mlab-modules/DATALOGGER02A/README.md

# DATALOGGER02A
<!--- LongName --->
## 
<!--- ELongName ---> 

<!--- Lead --->

<!--- ELead ---> 

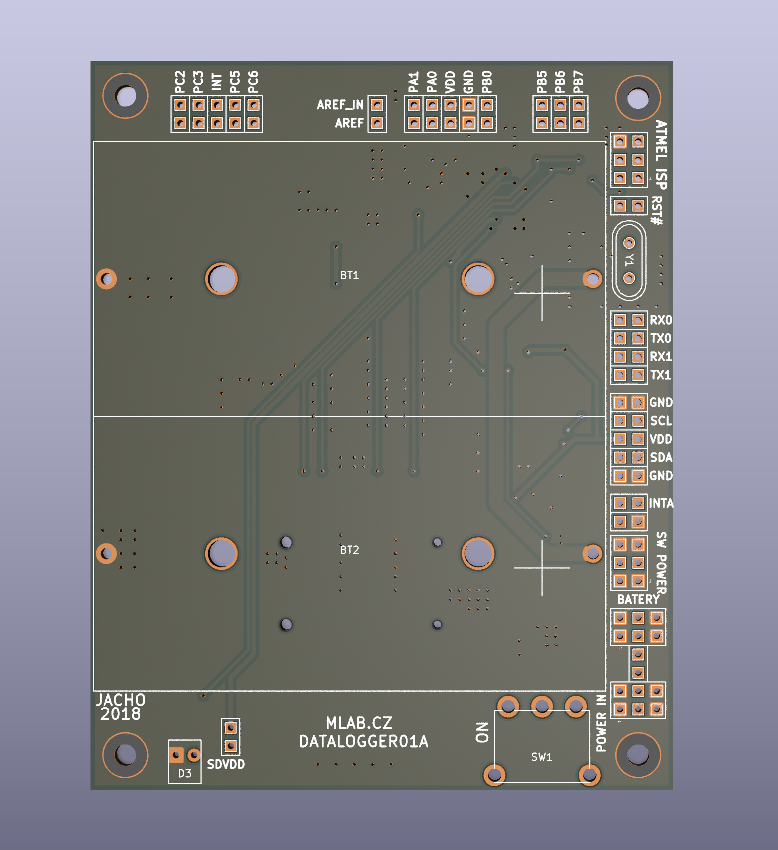
[picture p1: doc/img/DATALOGGER01A_top.png]
DATALOGGER01A
