mlab-modules/DATALOGGER02A/doc/gen/img/DATALOGGER02-bottom.png

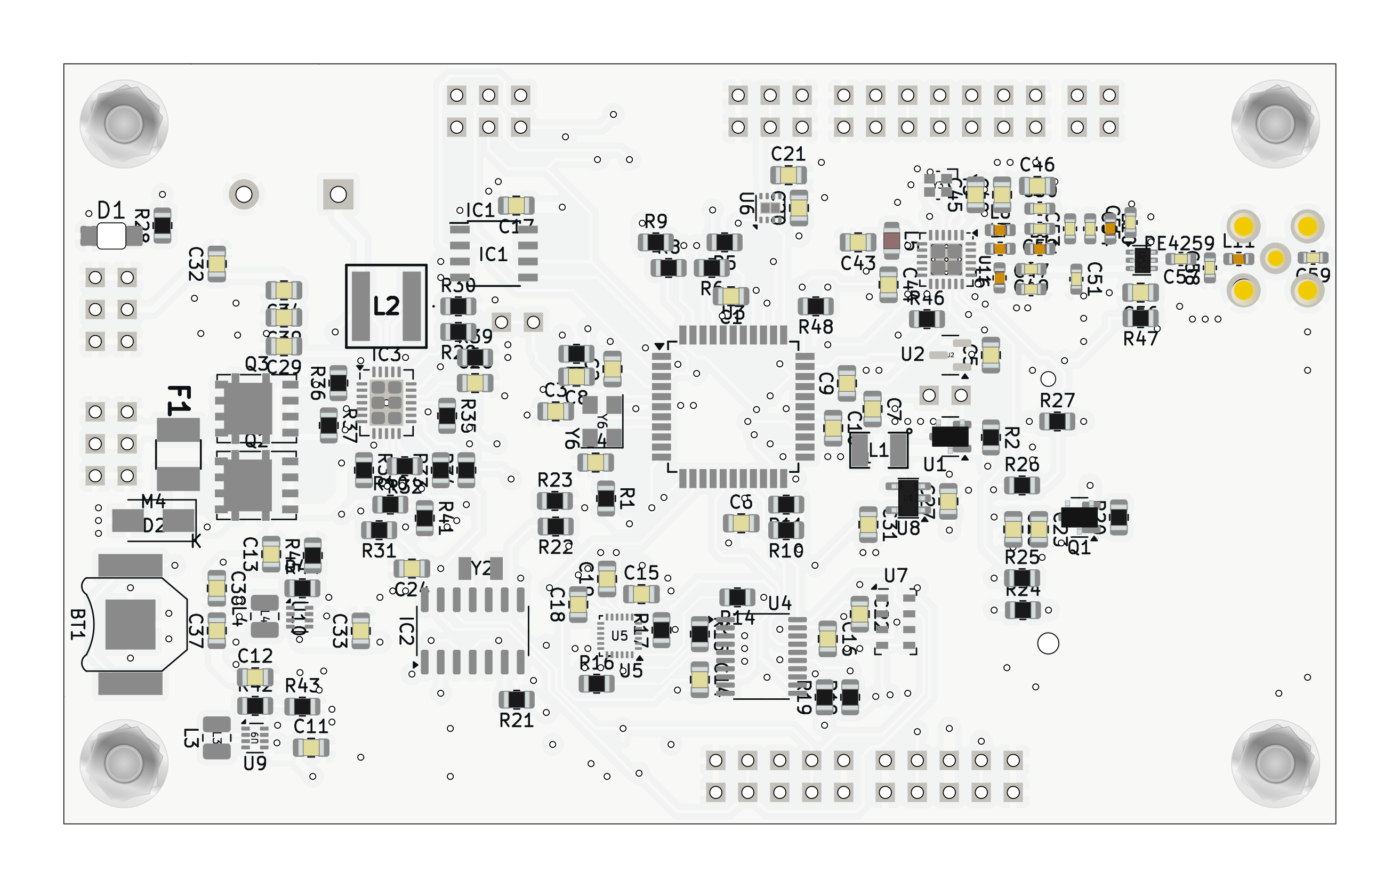
doc/gen/img/DATALOGGER02-bottom.png
