mlab-modules/DATALOGGER02A/doc/gen/img/DATALOGGER02-top.png

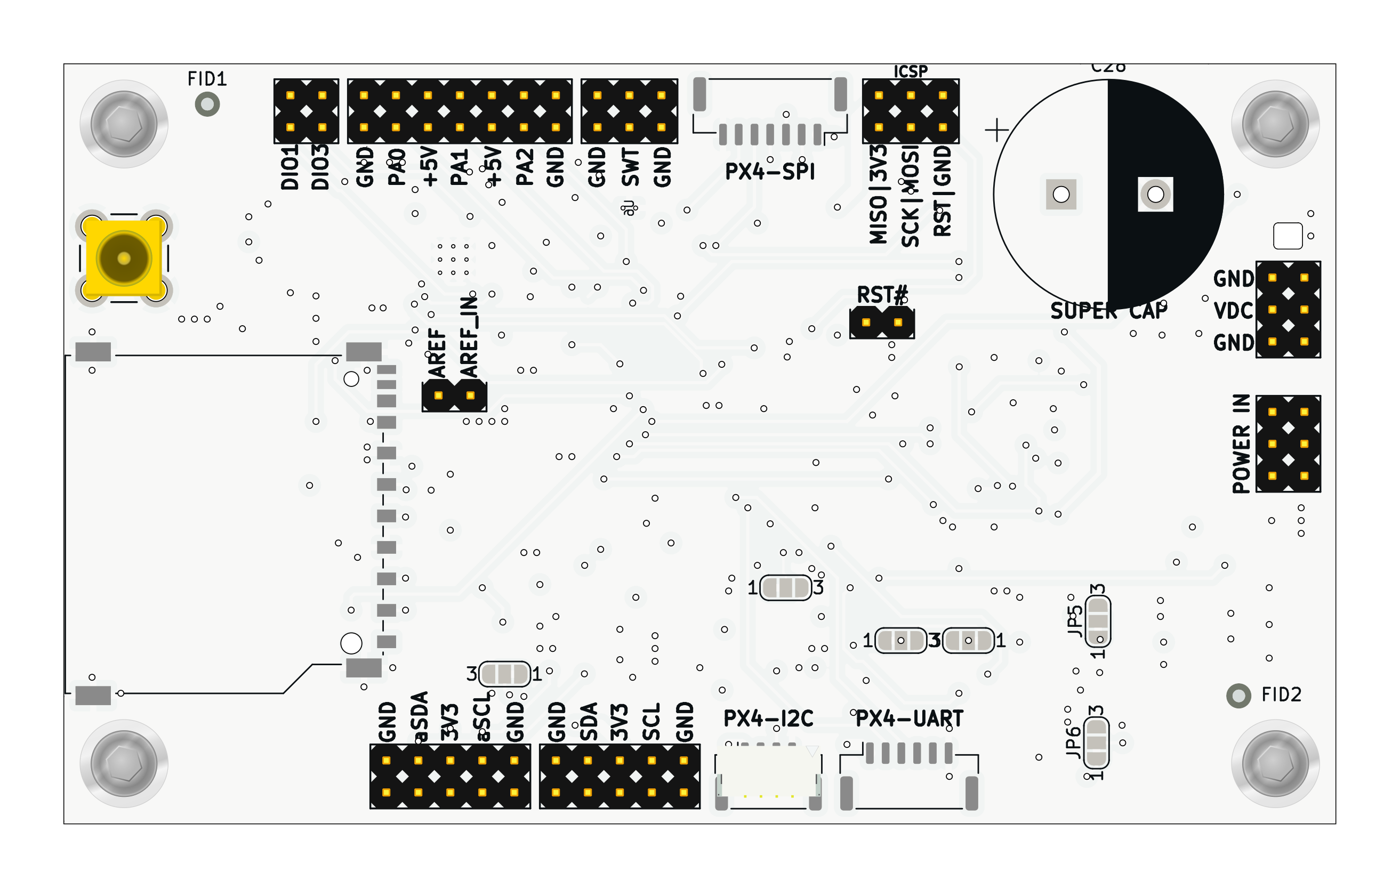
doc/gen/img/DATALOGGER02-top.png
