mlab-modules/DATALOGGER02A/doc/gen/DATALOGGER02.step

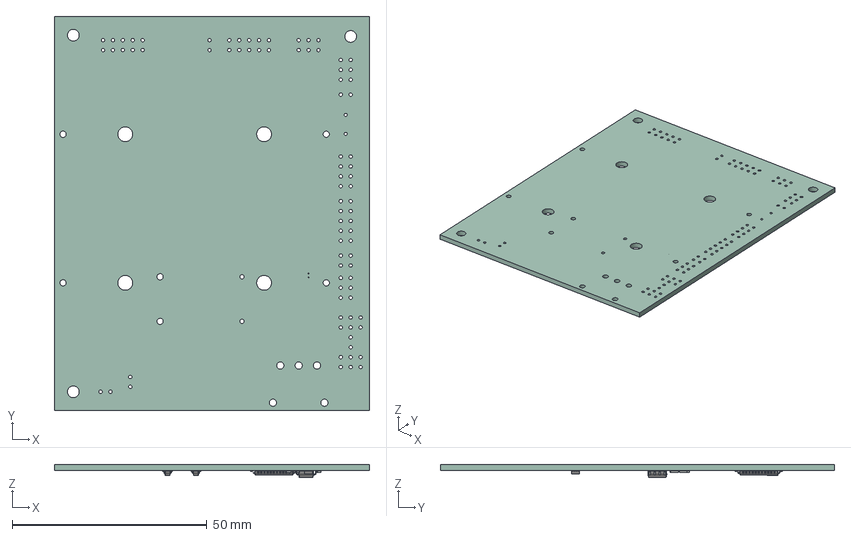
[picture p4: CAD file, 2025-01-04]
doc/gen/DATALOGGER02.step
80.8 x 101.1 x 3.40 mm
WSON_8_1EP_2x2mm_P05mm_EP09x16mm
TQFP_44_10x10mm_P08mm
SOT_23 x 2
R_0805_2012Metric x 5
SOIC_8_39x49mm_P127mm
kibot_lc1u32bj_PCB
