mlab-modules/DATALOGGER02A/doc/gen/dxf/DATALOGGER02-Edge_Cuts.dxf

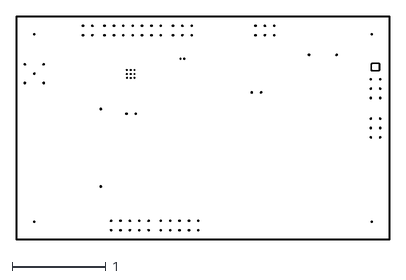
[picture p5: CAD file, 2025-01-23]
doc/gen/dxf/DATALOGGER02-Edge_Cuts.dxf
3.98 x 2.38
