mlab-modules/DATALOGGER02A/doc/gen/dxf/DATALOGGER02-User_Drawings.dxf

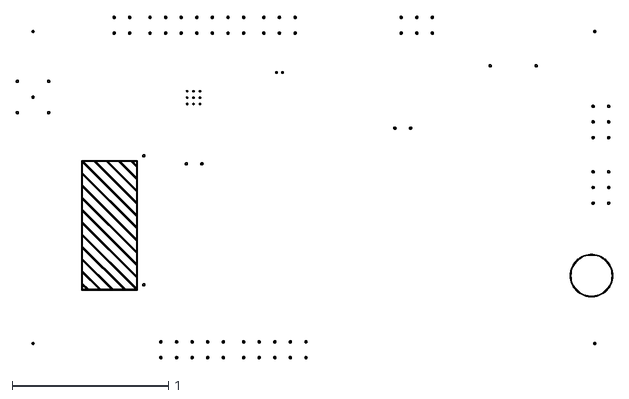
[picture p6: CAD file, 2025-01-23]
doc/gen/dxf/DATALOGGER02-User_Drawings.dxf
3.82 x 2.19
