mlab-modules/DATALOGGER02A/doc/gen/dxf/DATALOGGER02-F_Courtyard.dxf

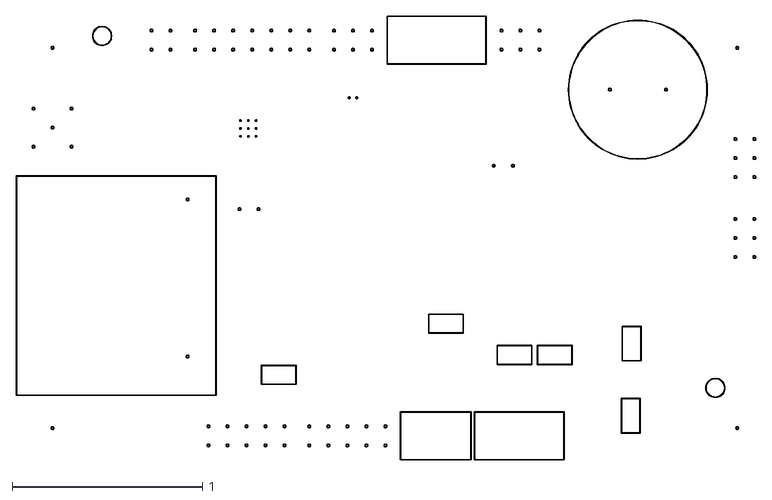
[picture p7: CAD file, 2025-01-23]
doc/gen/dxf/DATALOGGER02-F_Courtyard.dxf
3.89 x 2.33
