mlab-modules/DATALOGGER02A/doc/gen/dxf/DATALOGGER02-F_Fab.dxf

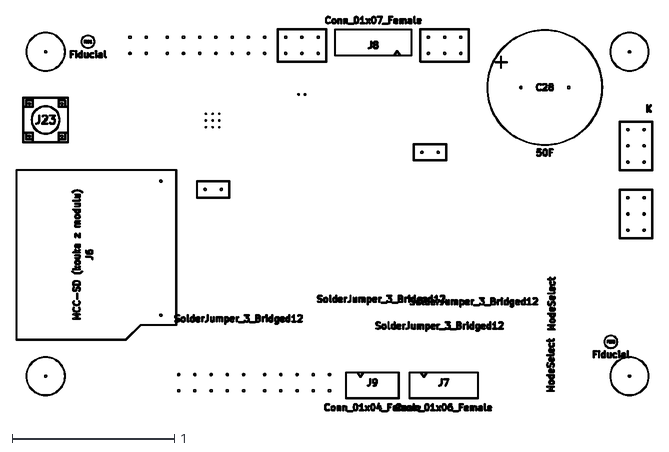
[picture p8: CAD file, 2025-01-23]
doc/gen/dxf/DATALOGGER02-F_Fab.dxf
3.92 x 2.44
