mlab-modules/DATALOGGER02A/doc/gen/dxf/DATALOGGER02-User_Comments.dxf

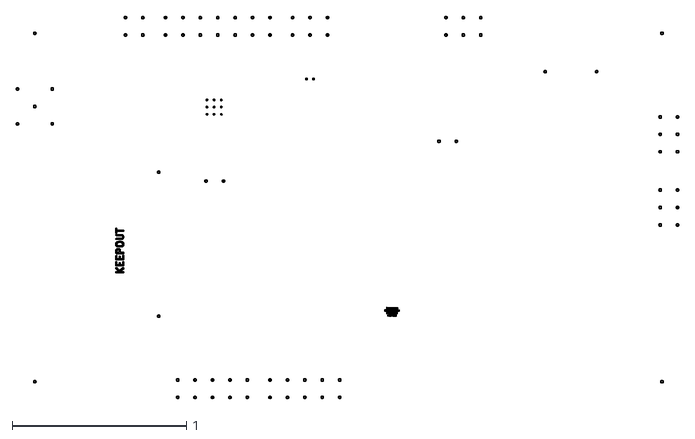
[picture p9: CAD file, 2025-01-23]
doc/gen/dxf/DATALOGGER02-User_Comments.dxf
3.80 x 2.19
