mlab-modules/DATALOGGER02A/doc/gen/dxf/DATALOGGER02-Margin.dxf

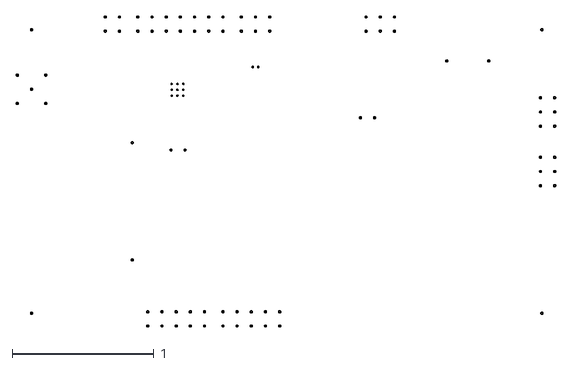
[picture p10: CAD file, 2025-01-23]
doc/gen/dxf/DATALOGGER02-Margin.dxf
3.80 x 2.19
