mlab-modules/DATALOGGER02A/doc/gen/dxf/DATALOGGER02-B_Courtyard.dxf

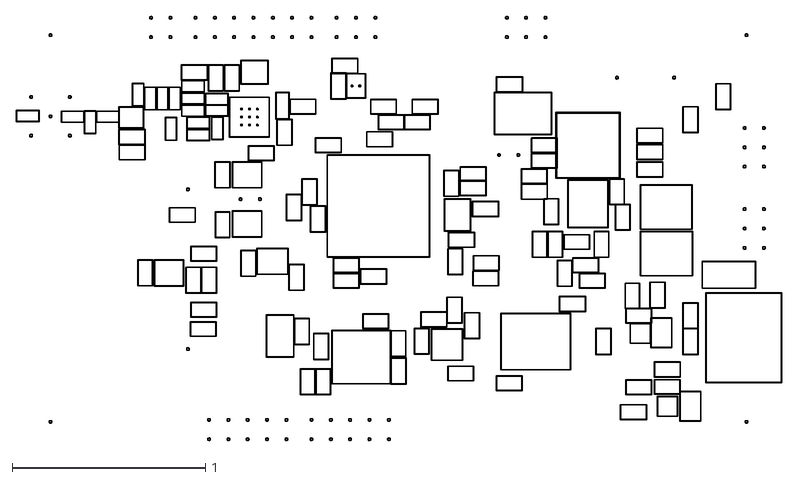
[picture p13: CAD file, 2025-01-23]
doc/gen/dxf/DATALOGGER02-B_Courtyard.dxf
3.96 x 2.19
