mlab-modules/DATALOGGER02A/doc/gen/dxf/DATALOGGER02-F_Cu.dxf

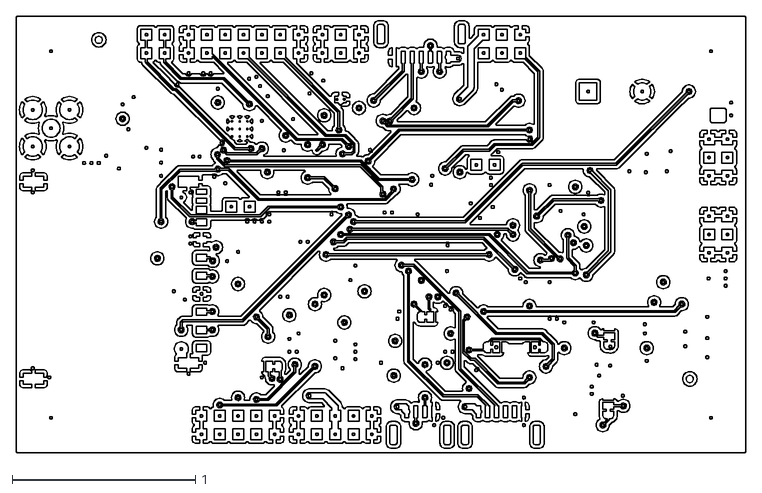
[picture p14: CAD file, 2025-01-23]
doc/gen/dxf/DATALOGGER02-F_Cu.dxf
3.98 x 2.38
