mlab-modules/DATALOGGER02A/doc/gen/dxf/DATALOGGER02-B_Fab.dxf

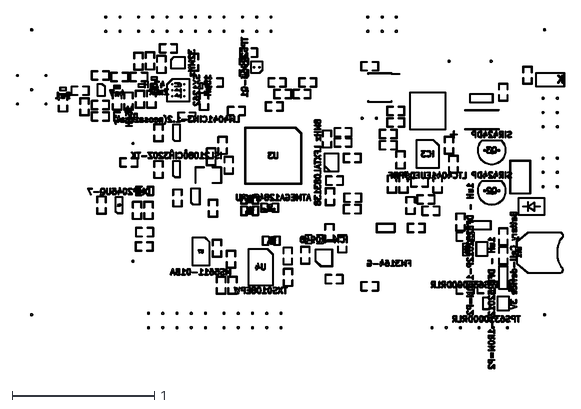
[picture p16: CAD file, 2025-01-22]
doc/gen/dxf/DATALOGGER02-B_Fab.dxf
3.85 x 2.48
