mlab-modules/DATALOGGER02A/(list of files, cad)

Other CAD files:
doc/gen/dxf/DATALOGGER02-B_Adhesive.dxf
doc/gen/dxf/DATALOGGER02-B_Mask.dxf
doc/gen/dxf/DATALOGGER02-B_Paste.dxf
doc/gen/dxf/DATALOGGER02-B_Silkscreen.dxf
doc/gen/dxf/DATALOGGER02-F_Mask.dxf
doc/gen/dxf/DATALOGGER02-F_Silkscreen.dxf
