mlab-modules/DATALOGGER02A/doc/gen/DATALOGGER02-schematic.pdf

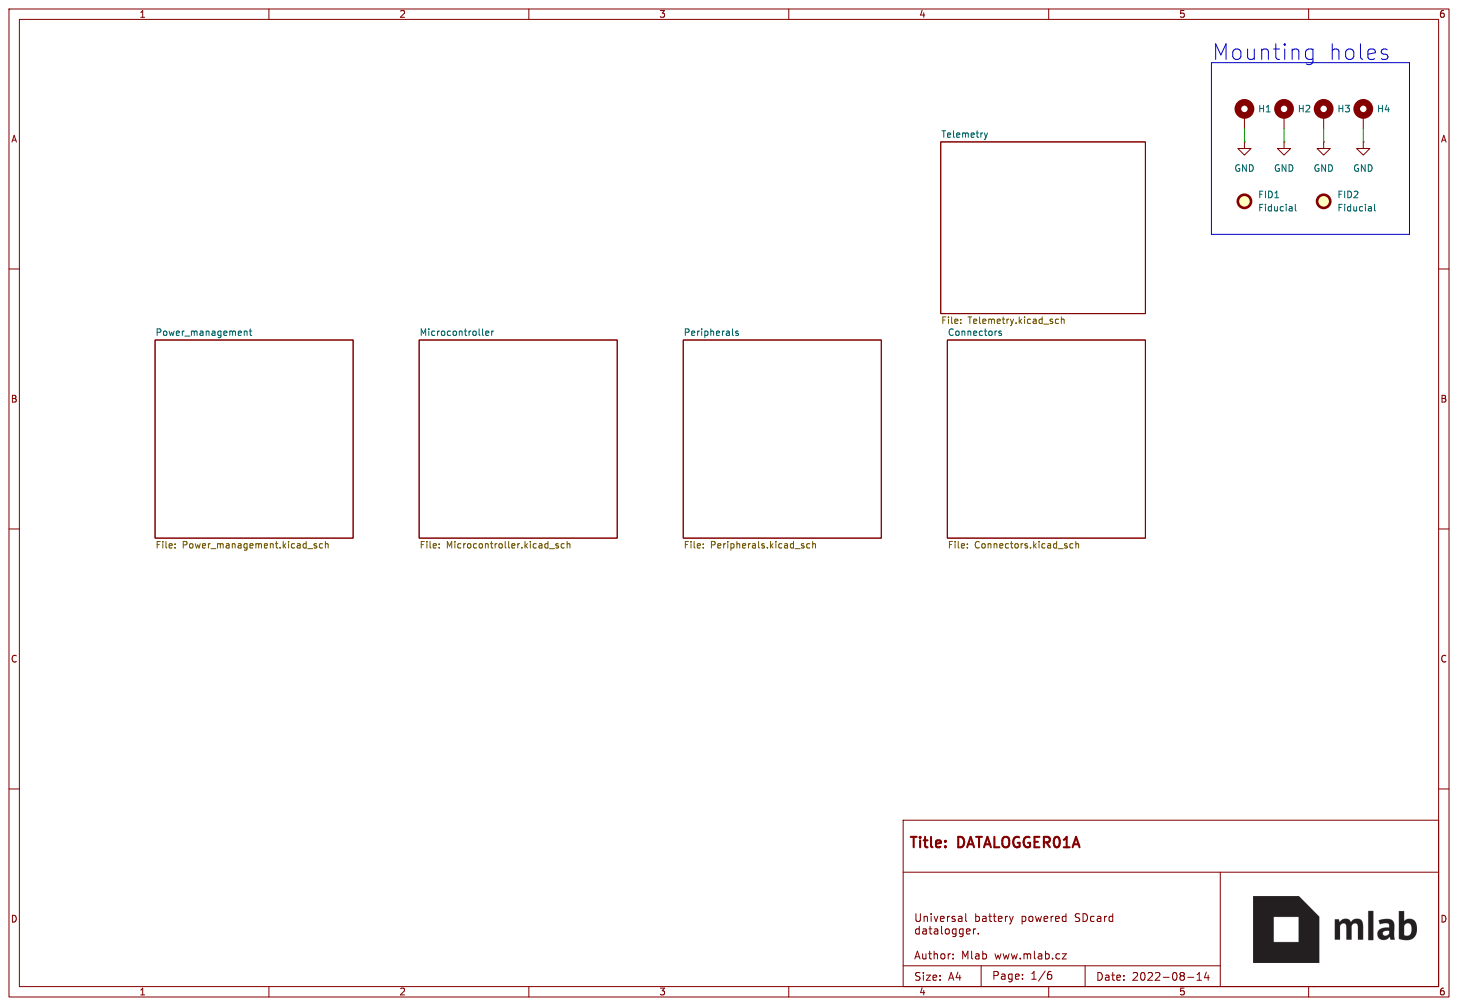
[picture p17: page 1]

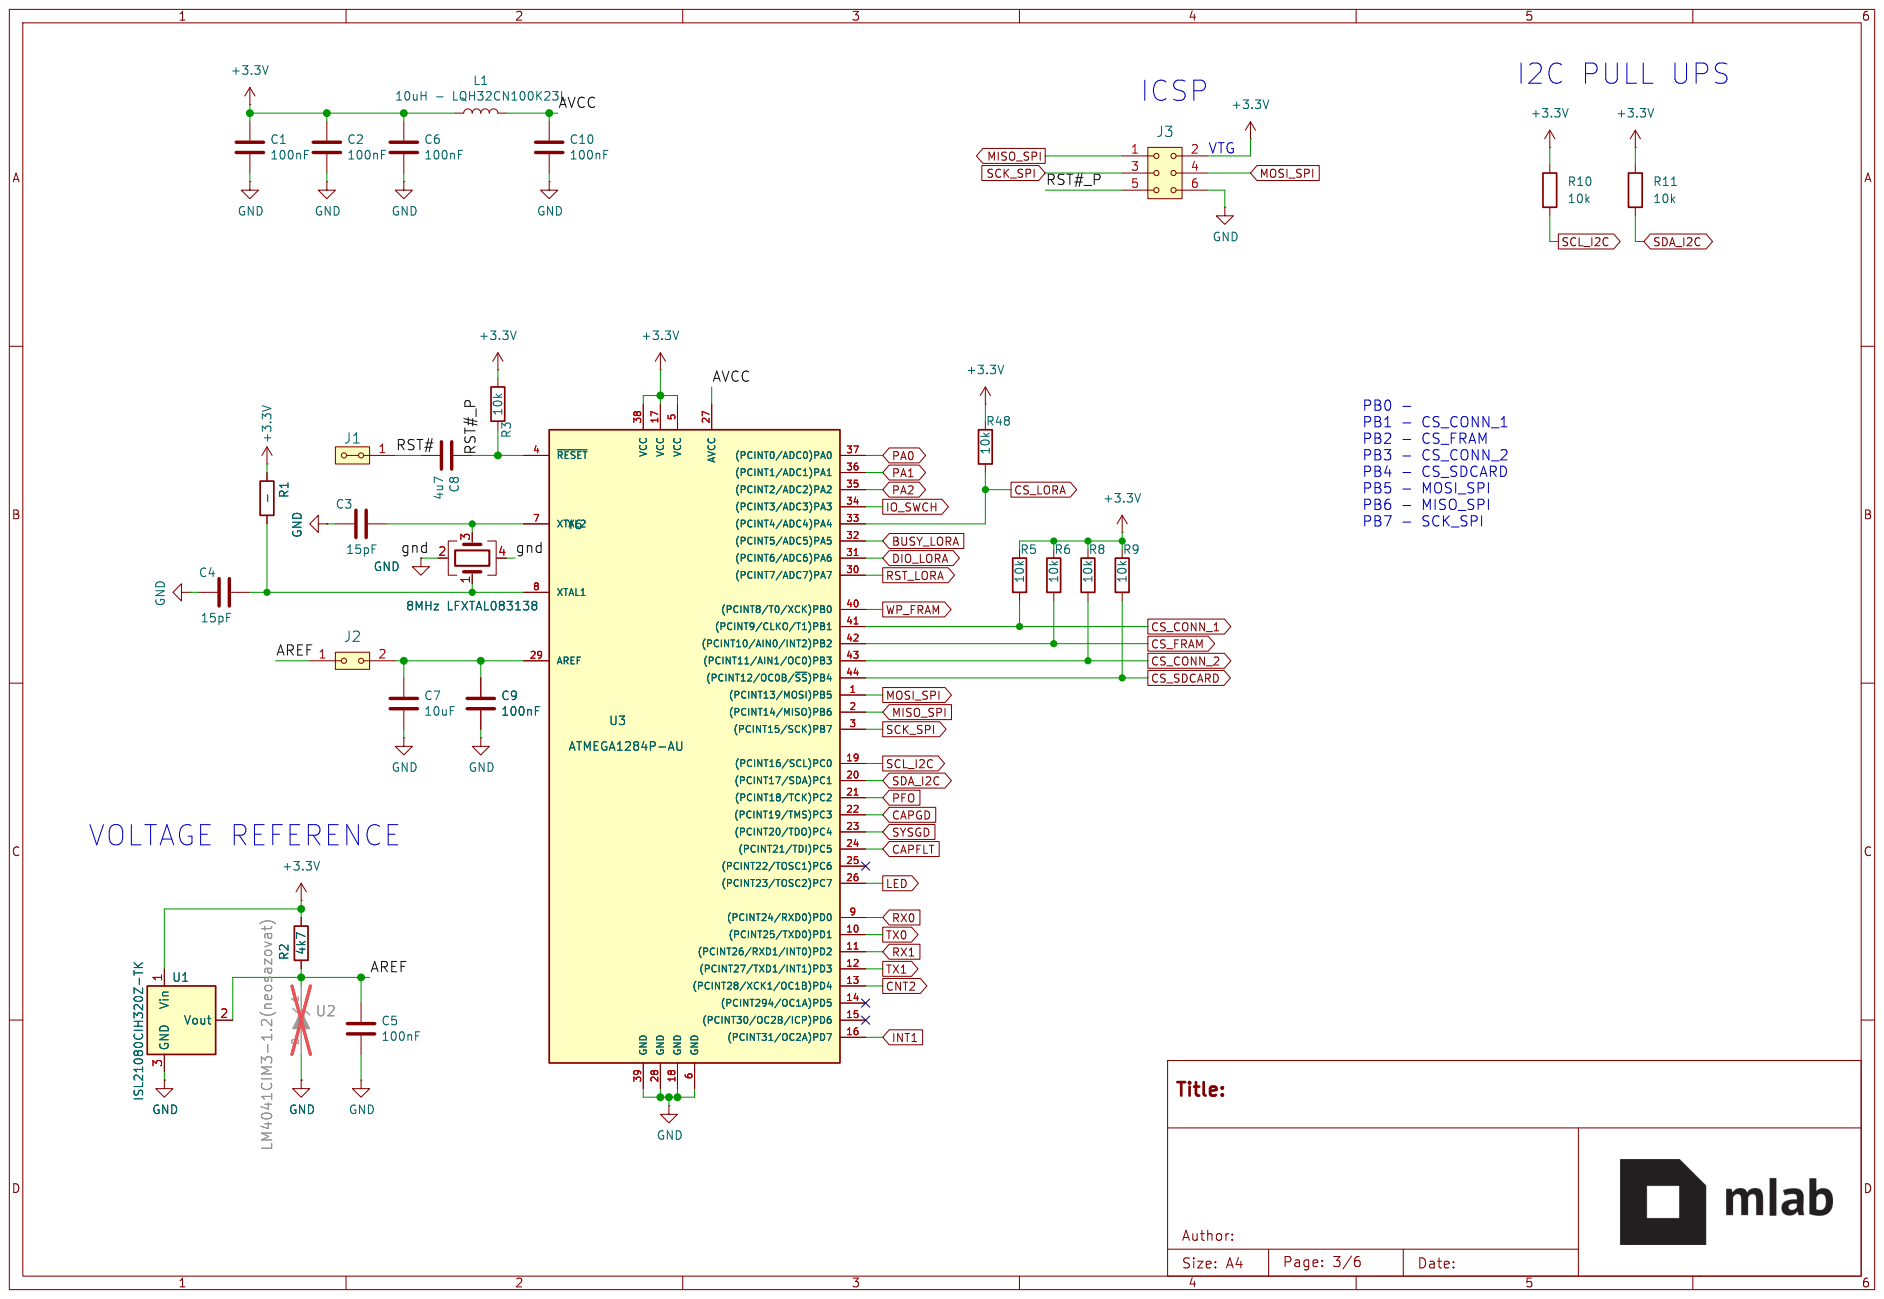
[picture p18: page 2]

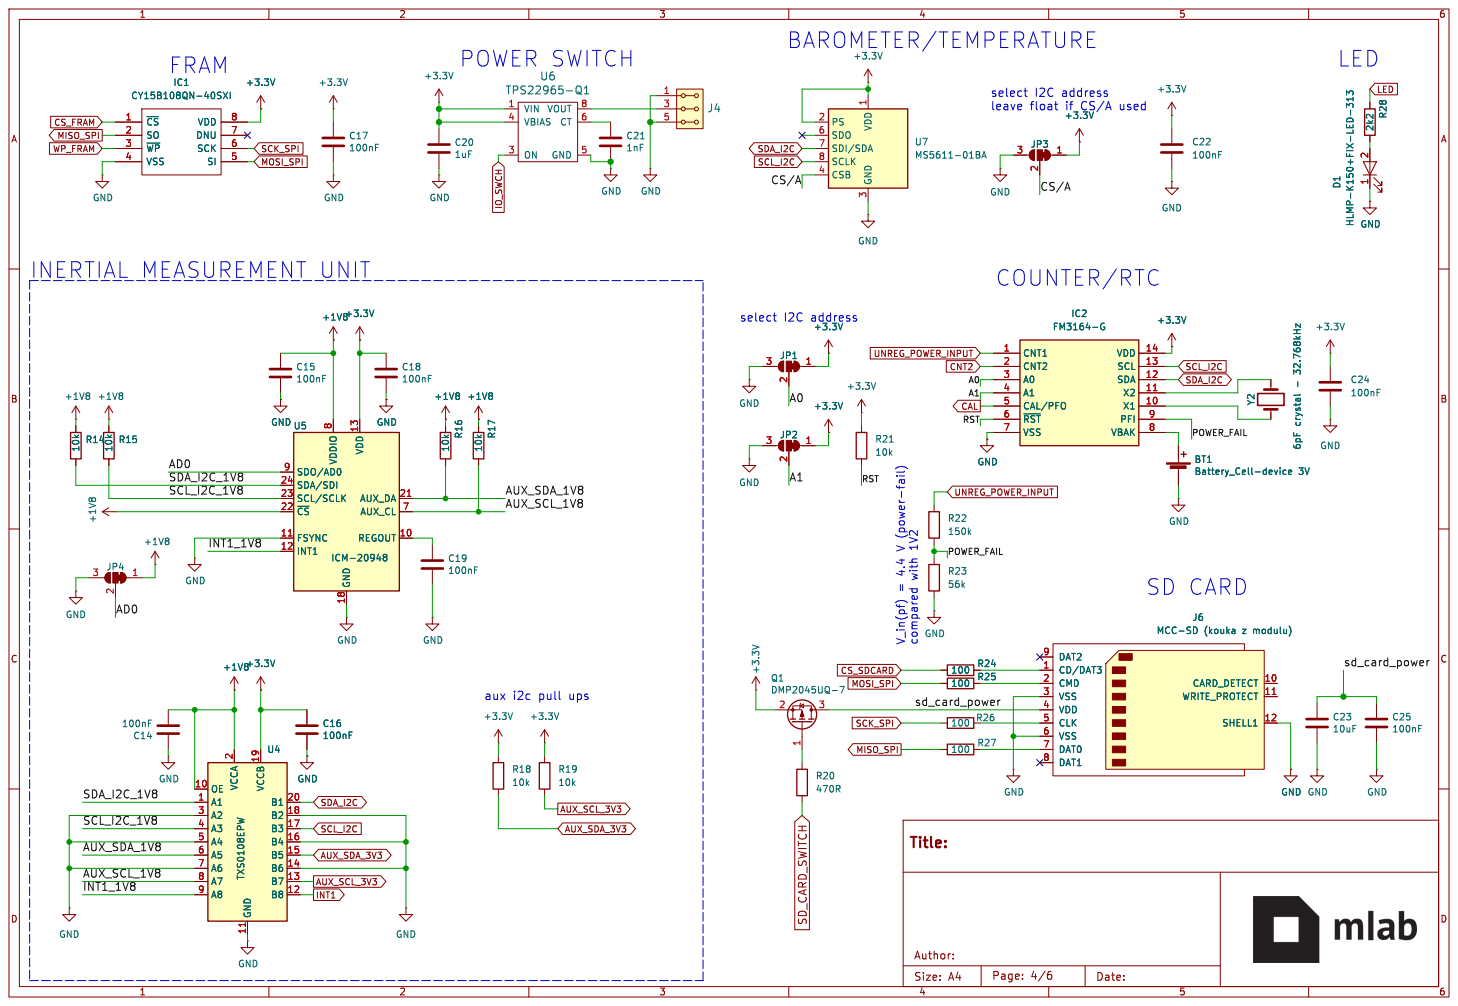
[picture p19: page 3]

LED V_in(pf) = 4.4 V (power-fail) compared with 1V2

select I2C address
leave float if CS/A used

3 CSB 4 SDO 6 SDI/SDA 7 SCLK 8 U7 MS5611-01BA CD/DAT3 1 CARD_DETECT 10 WRITE_PROTECT 11 SHELL1 12 CMD 2 VSS 3 VDD 4 CLK 5 VSS 6 DAT0 7 DAT1 8 DAT2 9

J6 MCC-SD (kouka z modulu) R25

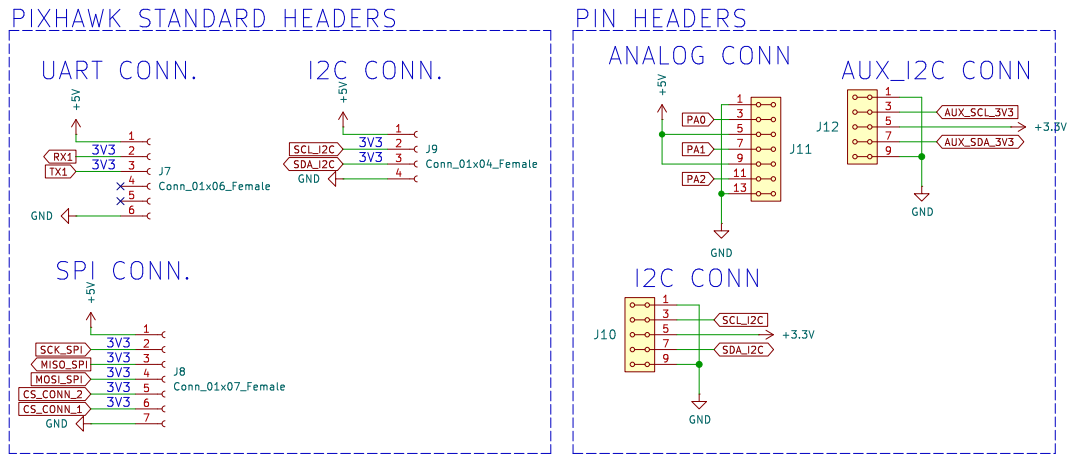
[picture p20: page 4]

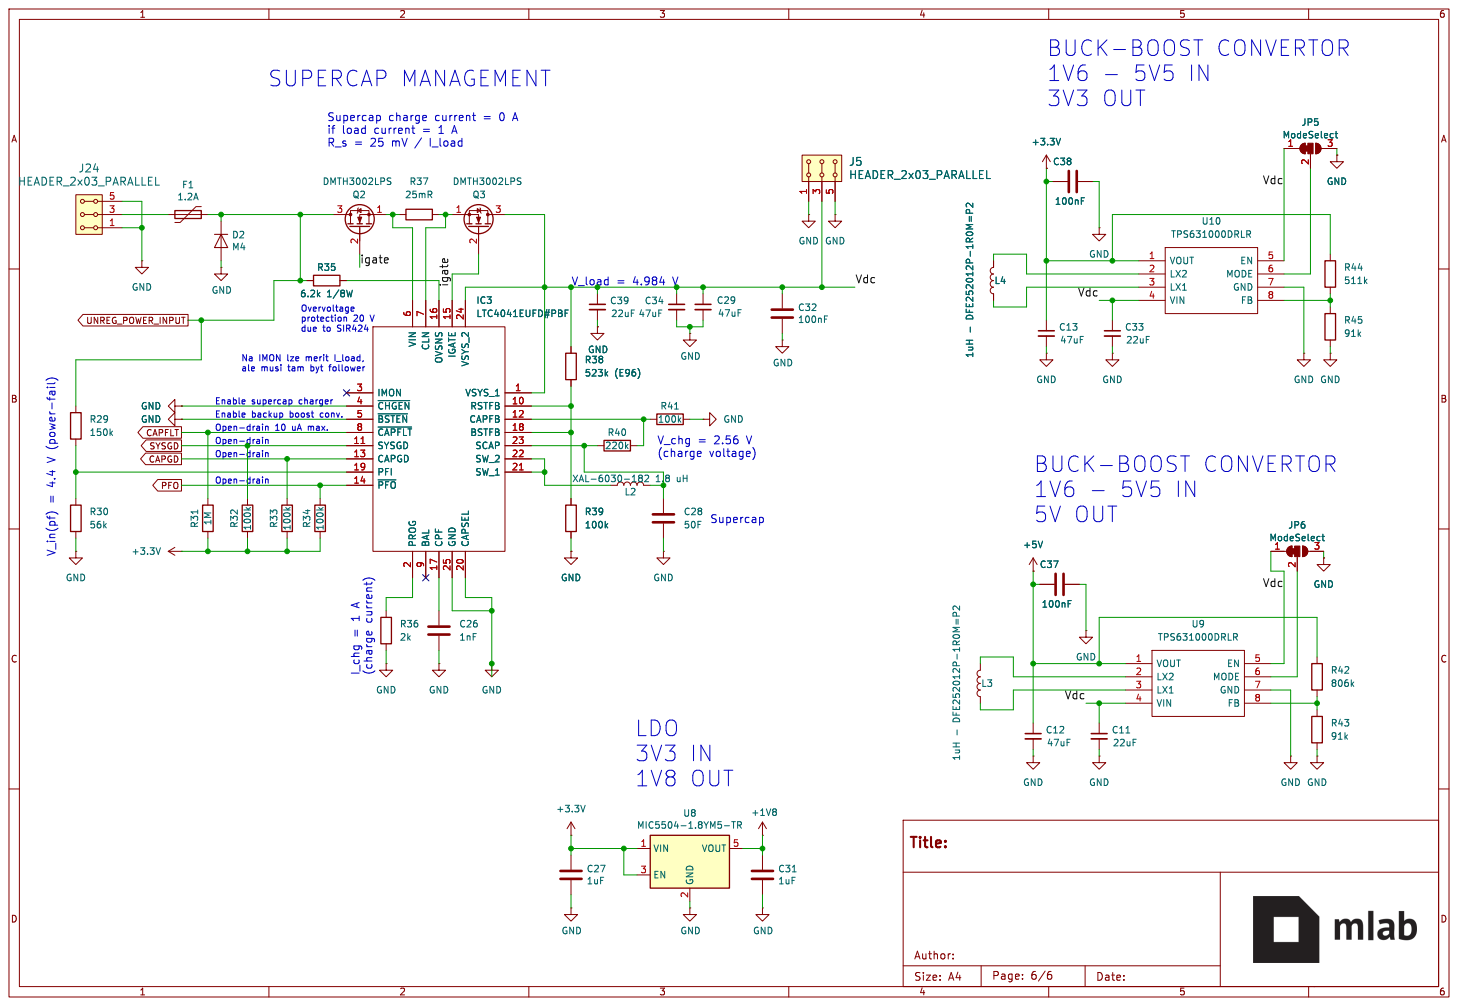
[picture p21: page 5]

3V3 OUT V_in(pf) = 4.4 V (power-fail)

Supercap charge current = 0 A
if load current = 1 A R_s = 25 mV / I_load

(charge voltage) Na IMON lze merit I_load, ale musi tam byt follower Overvoltage

2 EN 3 VOUT 5 U8 MIC5504-1.8YM5-TR GND GND GND

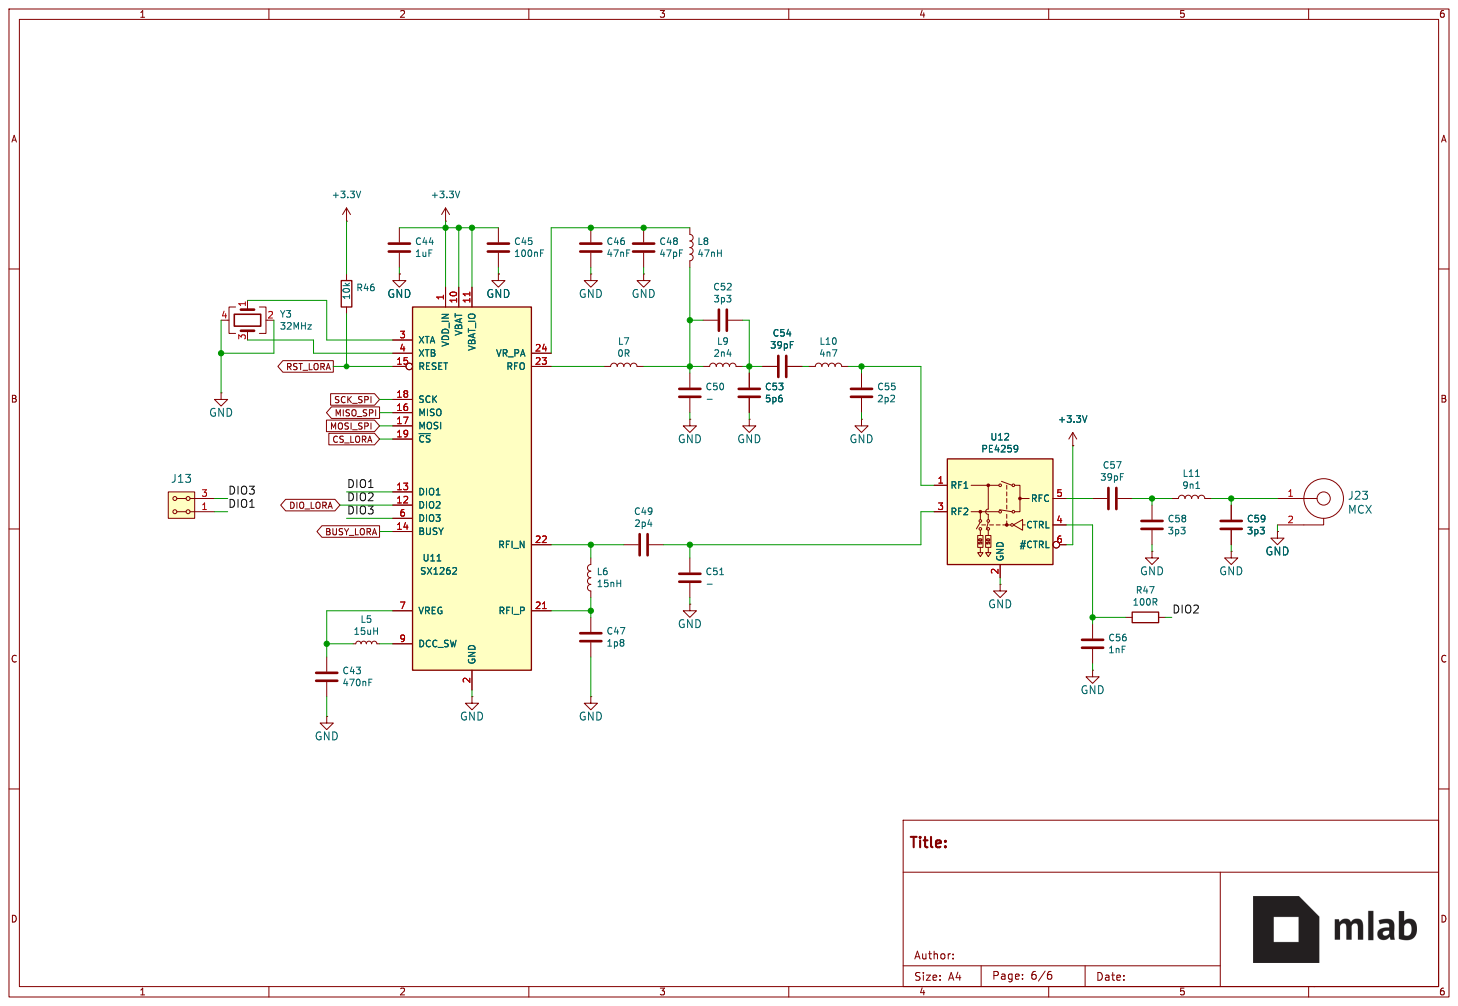
[picture p22: page 6]

1 VBAT 10 VBAT_IO 11 DIO2 12 DIO1 13 BUSY 14 RESET 15 MISO 16 MOSI 17 SCK 18 ~{CS} 19 GND
DIO2 U11 SX1262VDD_IN

2 RFI_P 21 RFI_N 22 RFO 23 VR_PA 24 XTA 3 XTB 4 DIO3 6 VREG 7 DCC_SW 9 C54

2 RFI_P 21 RFI_N 22 RFO 23 VR_PA 24 XTA 3 XTB 4 DIO3 6 VREG 7 DCC_SW 9 U11 SX1262 C49
