mlab-modules/DATALOGGER02A/hw/cam_profi/assembly/DATALOGGER02-B_Fab+Edge_Cuts.pdf

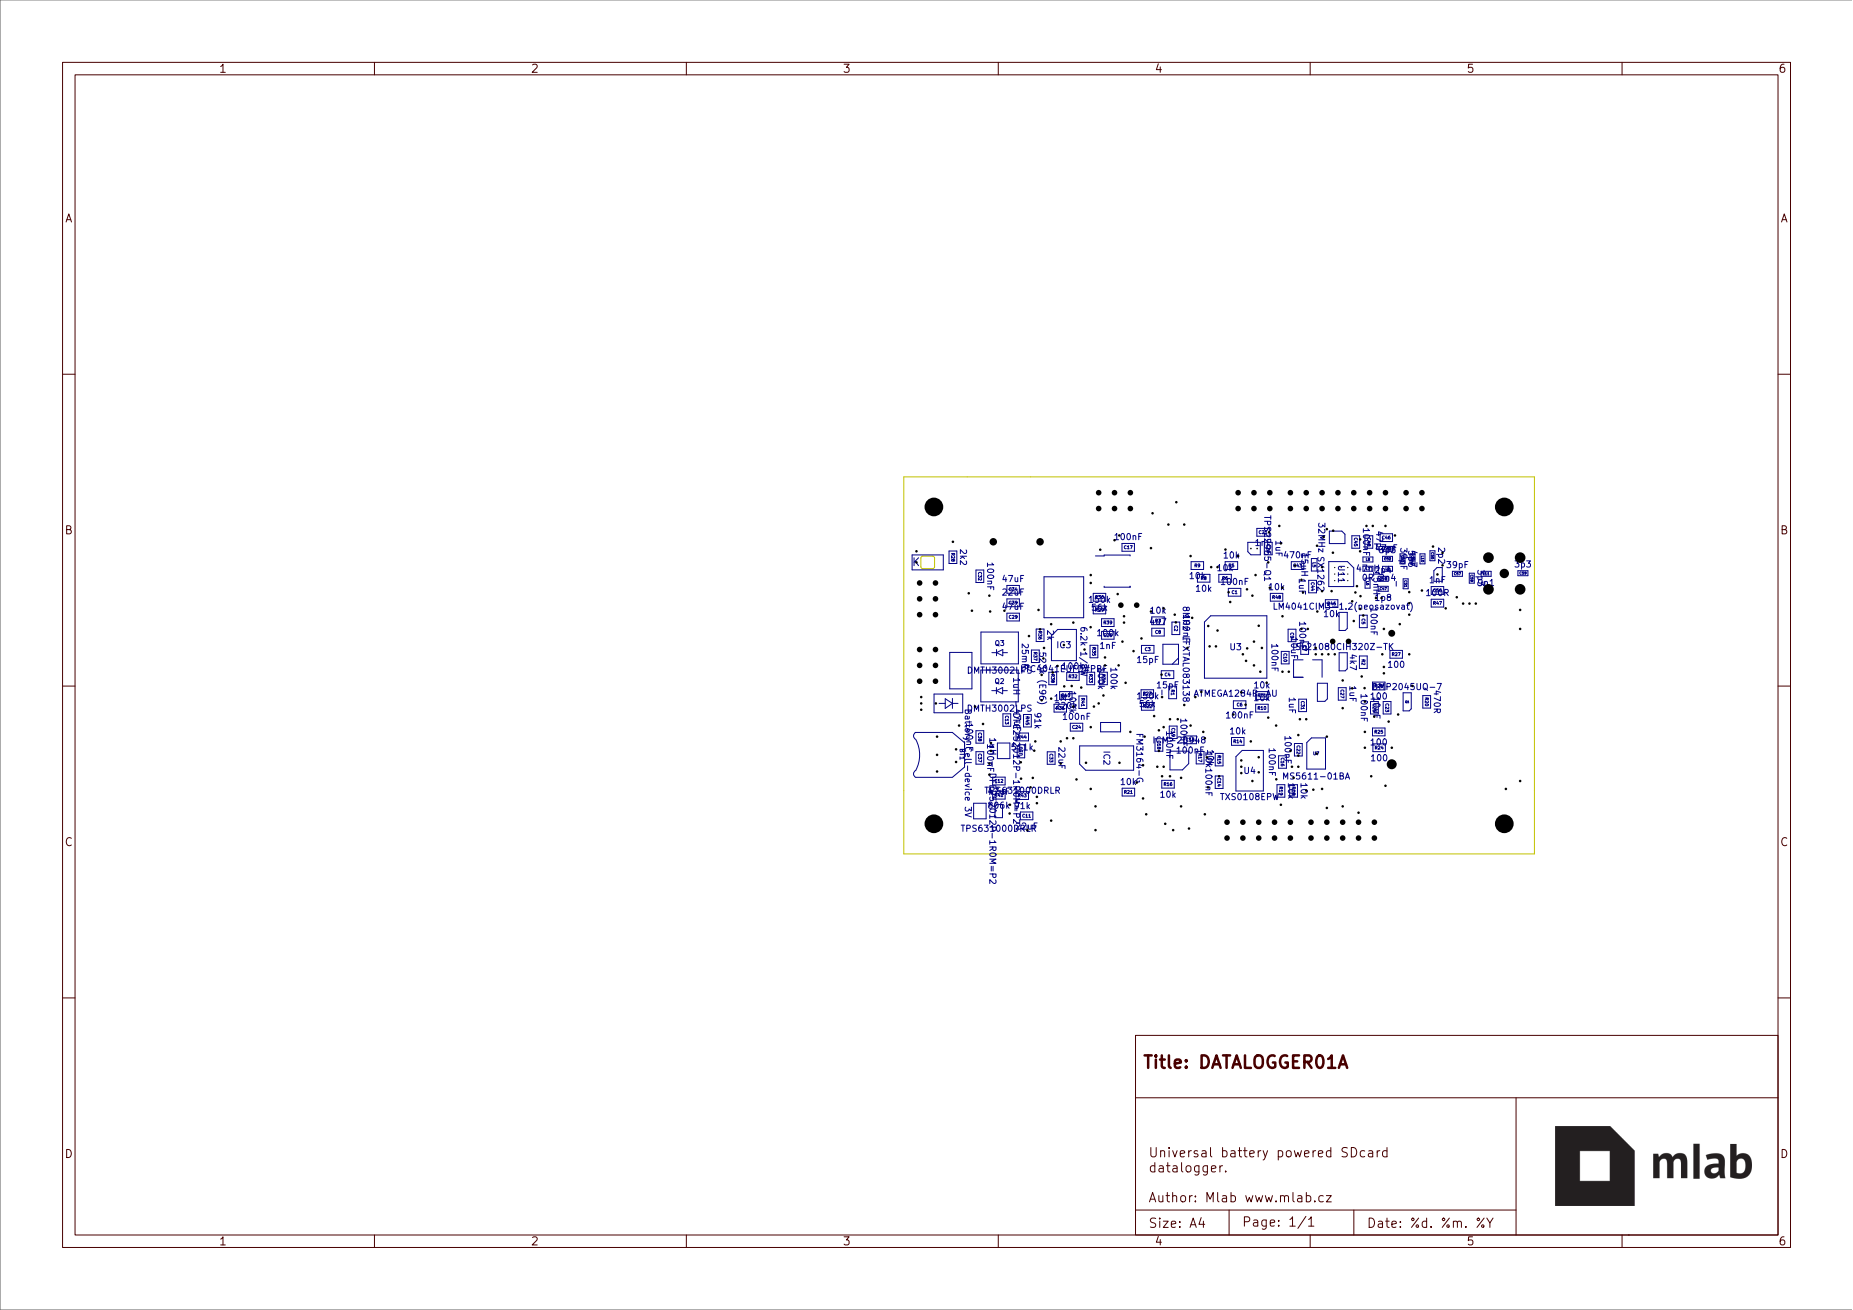
[picture p23: page 1]
