mlab-modules/DATALOGGER02A/hw/cam_profi/assembly/DATALOGGER02-F_Fab+Edge_Cuts.pdf

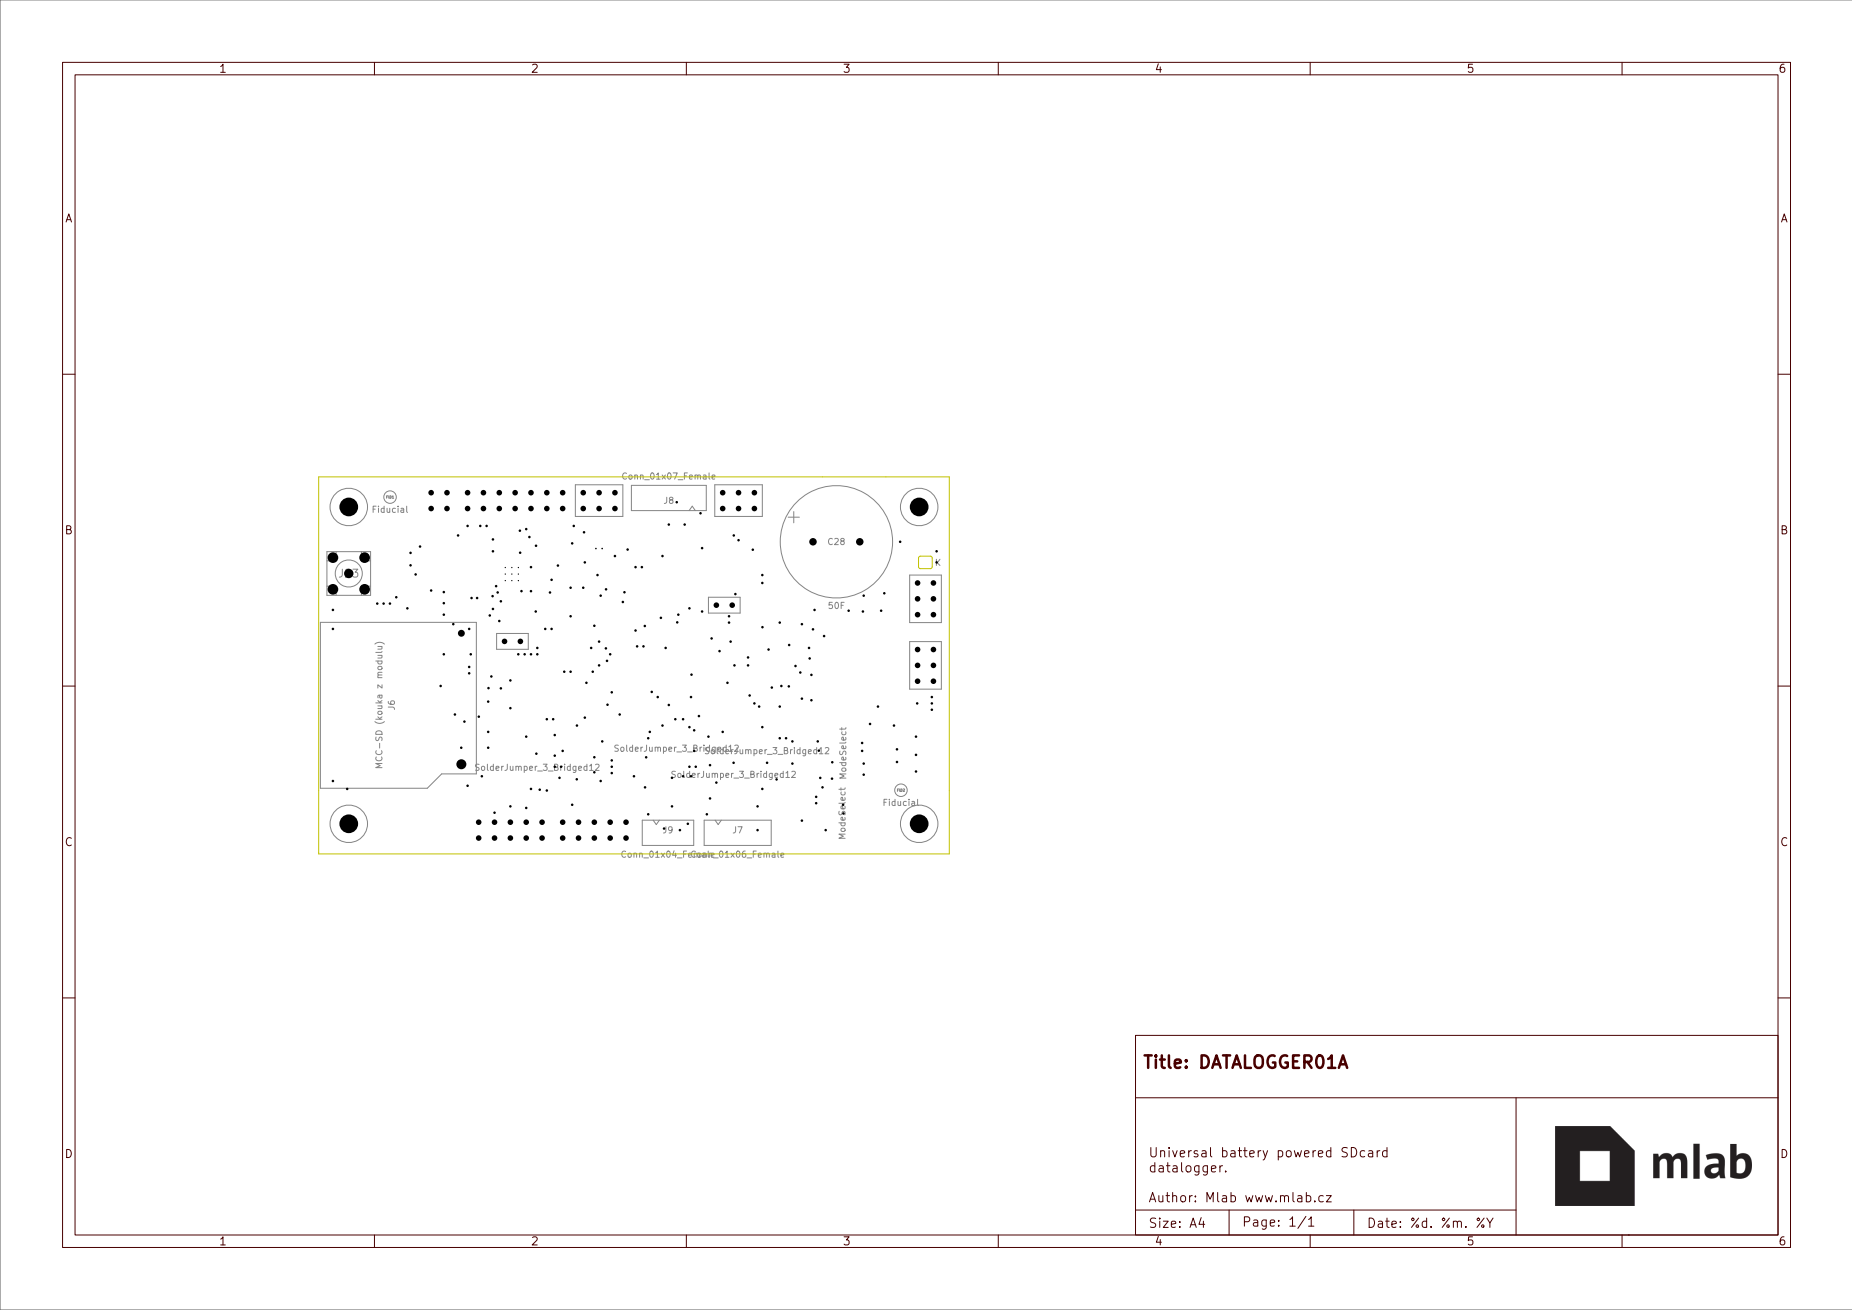
[picture p24: page 1]
