mlab-modules/DATALOGGER02A/(commit log)

2023-01-04 Update actions products
    [DATALOGGER01A-B_Cu.gbr, DATALOGGER01A-B_Mask.gbr, DATALOGGER01A-B_Paste.gbr, DATALOGGER01A-B_Silkscreen.gbr, DATALOGGER01A-Edge_Cuts.gbr, DATALOGGER01A-F_Cu.gbr, DATALOGGER01A-F_Mask.gbr, DATALOGGER01A-F_Silkscreen.gbr]
2023-01-04 Remove production files for version 01A
    [DATALOGGER01A-B_Adhesive.dxf, DATALOGGER01A-B_Courtyard.dxf, DATALOGGER01A-B_Cu.dxf, DATALOGGER01A-B_Fab.dxf, DATALOGGER01A-B_Mask.dxf, DATALOGGER01A-B_Paste.dxf, DATALOGGER01A-B_Silkscreen.dxf, DATALOGGER01A-Edge_Cuts.dxf]
2023-01-04 IMU schema
    [DATALOGGER02A.kicad_sch]
2023-01-09 update of schematics
    [Connectors.kicad_sch, Microcontroller.kicad_sch, Peripherals.kicad_sch]
2023-01-09 ltc4041 update
    [Connectors.kicad_sch, DATALOGGER02A.kicad_sch, Microcontroller.kicad_sch, Peripherals.kicad_sch, Power_management.kicad_sch]
2023-01-10 schematics update - LTC4041, TPS631000
    [Connectors.kicad_sch, DATALOGGER02A.kicad_sch, Microcontroller.kicad_sch, Peripherals.kicad_sch, Power_management.kicad_sch]
2023-07-05 automated commit; rename source files to new naming convence
    [DATALOGGER02.kicad_pcb, DATALOGGER02.kicad_sch]
2023-09-15 Cleanup of repository.
    [Connectors.kicad_sch, DATALOGGER02.kicad_sch, Microcontroller.kicad_sch, Peripherals.kicad_sch, Power_management.kicad_sch, battery.kicad_sch]
2024-09-29 Removing Li-ion accumulator BMS Adding ISM02B LoRa telemetry block.
    [Connectors.kicad_sch, DATALOGGER02.kicad_pcb, DATALOGGER02.kicad_sch, Microcontroller.kicad_sch, Peripherals.kicad_sch, Power_management.kicad_sch, Telemetry.kicad_sch]
2025-01-03 schematics update
    [Connectors.kicad_sch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]
2025-01-22 another updates
    [DATALOGGER02.kicad_pcb]
2025-01-22 silkmasks done
    [DATALOGGER02.kicad_pcb, DATALOGGER02A.kicad_pcb, DATALOGGER02A.kicad_sch, Peripherals2.kicad_sch, Power_supply.kicad_sch, Telemetry.kicad_sch, battery.kicad_sch]
2025-01-22 checks 'passed'
    [DATALOGGER02.kicad_pcb]
2025-01-22 Update components from libraries. Improve schematics. Resolve some ERC and DRC errors.
    [Connectors.kicad_sch, DATALOGGER02.kicad_pcb, DATALOGGER02.kicad_sch, Microcontroller.kicad_sch, Peripherals.kicad_sch, Power_management.kicad_sch, Telemetry.kicad_sch]
2025-01-23 Update footprints. Improve layout Fix some DRC errors. Set components values matching inventory.
    [DATALOGGER02.kicad_pcb, Microcontroller.kicad_sch, Peripherals.kicad_sch, Power_management.kicad_sch, Telemetry.kicad_sch]
2025-01-23 Fix component placement and layout of telemetry transceiver.
    [DATALOGGER02.kicad_pcb, Telemetry.kicad_sch]
