mlab-modules/DATALOGGER02A/(notices)

Notices in the files:
hw/sch_pcb/DATALOGGER02.kicad_sch:
GPL 3.0
